plektra/ESP32-PDM-base/3d/ESD_GG0402_KAV.step

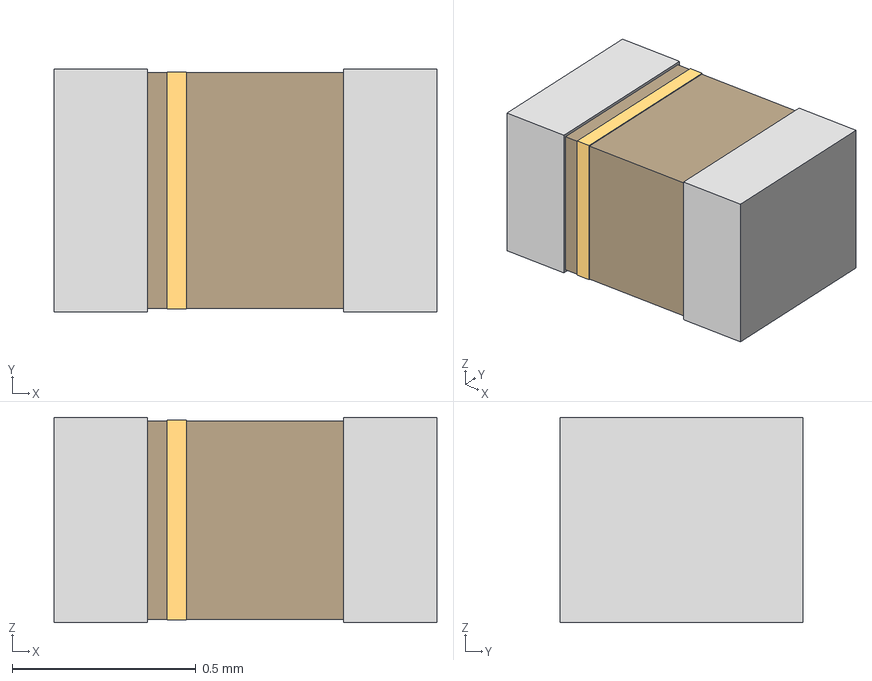
[picture p2: CAD file, 2025-01-17]
3d/ESD_GG0402_KAV.step
1.04 x 0.66 x 0.559 mm
