plektra/ESP32-PDM-base/3d/VLS6045AF-8R2M.STEP

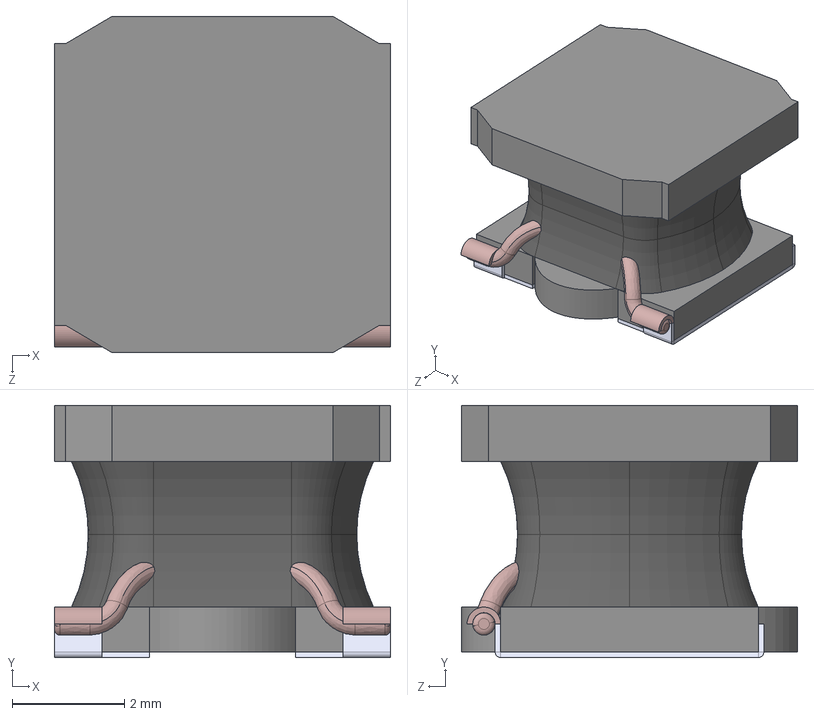
[picture p3: CAD file, 2025-01-17]
3d/VLS6045AF-8R2M.STEP
6.00 x 4.50 x 6.00 mm
