plektra/ESP32-PDM-base/3d/0ZCK0050FF2E.step

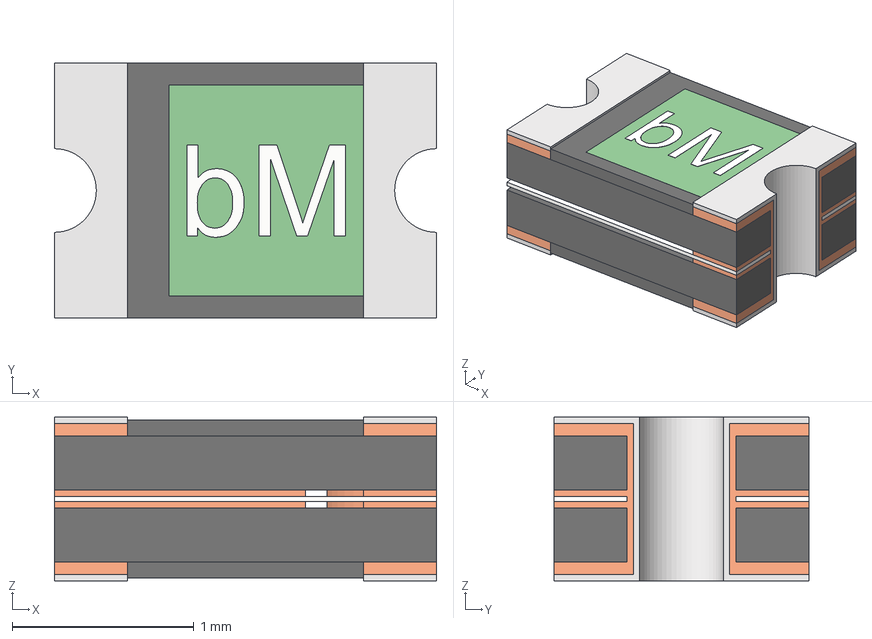
[picture p4: CAD file, 2025-01-17]
3d/0ZCK0050FF2E.step
2.10 x 1.40 x 0.9 mm
0ZCK0050FF2E_PART1
0ZCK0050FF2E_PART2
0ZCK0050FF2E_PART3
0ZCK0050FF2E_PART4
0ZCK0050FF2E_PART5
0ZCK0050FF2E_PART6
0ZCK0050FF2E_PART7
0ZCK0050FF2E_PART8
0ZCK0050FF2E_PART9
0ZCK0050FF2E_PART10
0ZCK0050FF2E_PART11
0ZCK0050FF2E_PART12
0ZCK0050FF2E_PART13
0ZCK0050FF2E_PART14
0ZCK0050FF2E_PART15
