plektra/ESP32-PDM-base/3d/USB4115-03-C_REVB4.step

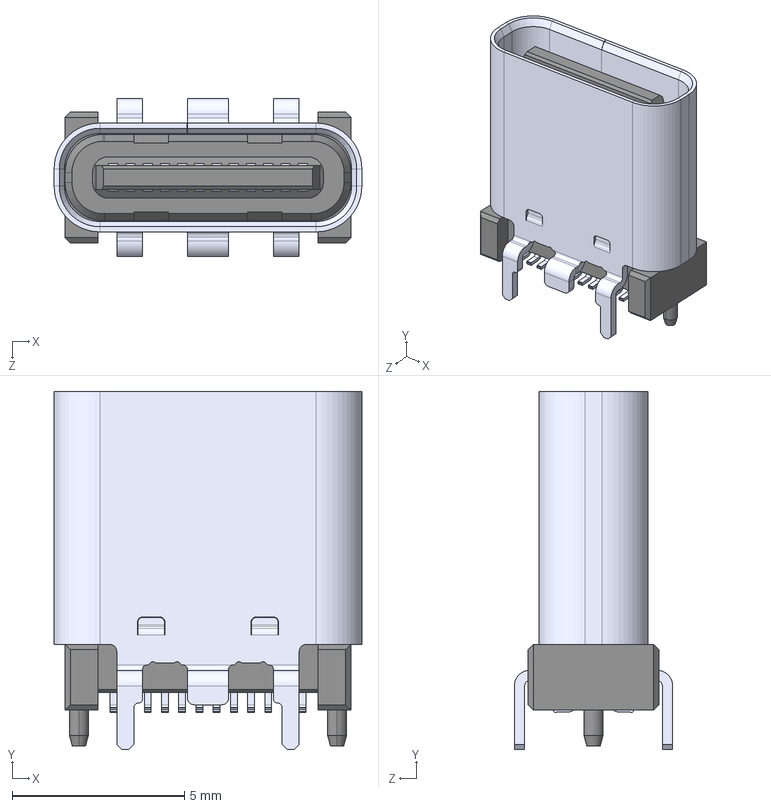
[picture p5: CAD file, 2025-01-17]
3d/USB4115-03-C_REVB4.step
8.94 x 10.4 x 4.60 mm
