plektra/ESP32-PDM-base/3d/USB4145-03-0170-C_REVA2.step

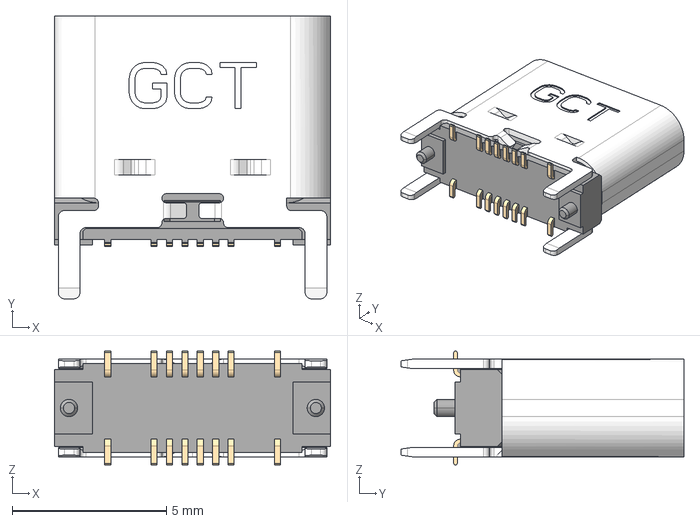
[picture p6: CAD file, 2025-01-17]
3d/USB4145-03-0170-C_REVA2.step
8.95 x 9.16 x 3.69 mm
