plektra/ESP32-PDM-base/3d/0ZCG0050AF2C.step

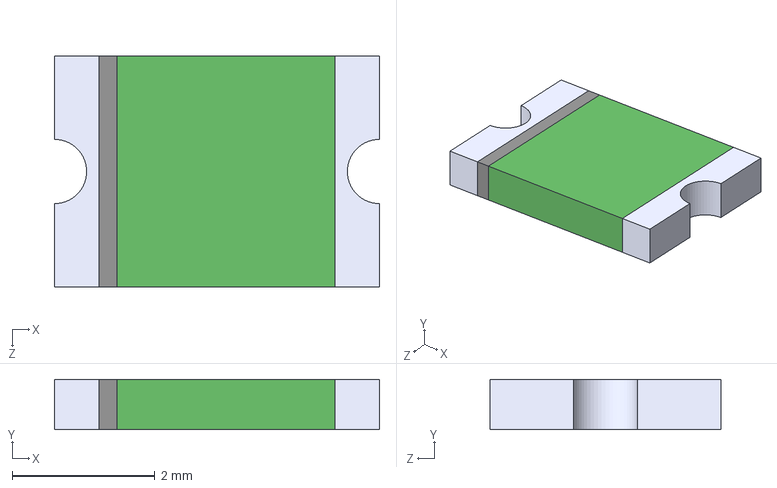
[picture p7: CAD file, 2025-01-17]
3d/0ZCG0050AF2C.step
4.55 x 0.7 x 3.24 mm
