plektra/ESP32-PDM-base/3d/DSS14UTR.step

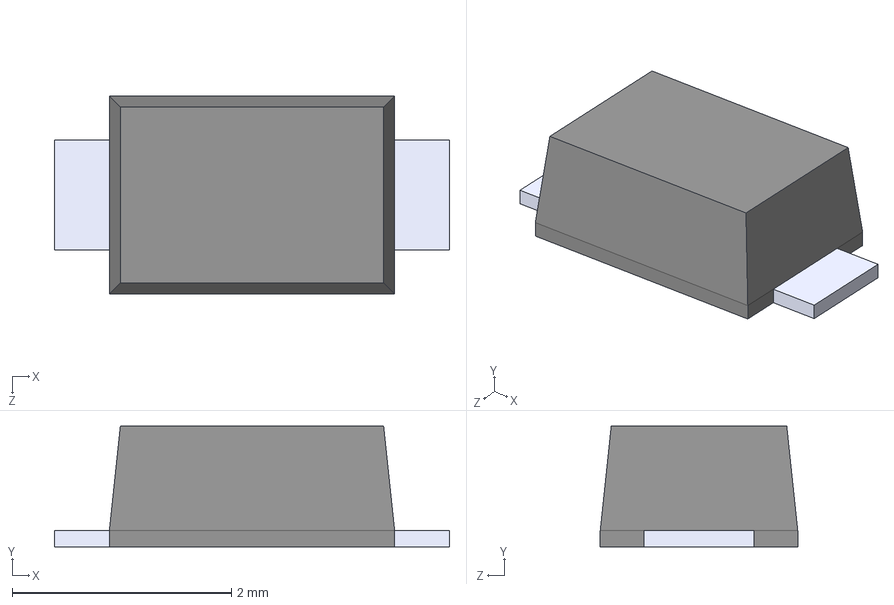
[picture p8: CAD file, 2025-01-17]
3d/DSS14UTR.step
3.60 x 1.10 x 1.80 mm
