plektra/ESP32-PDM-base/ESP32-PDM-BASE.kicad_pcb

## KiCad design ESP32-PDM-BASE.kicad_pcb (2026-10-29)

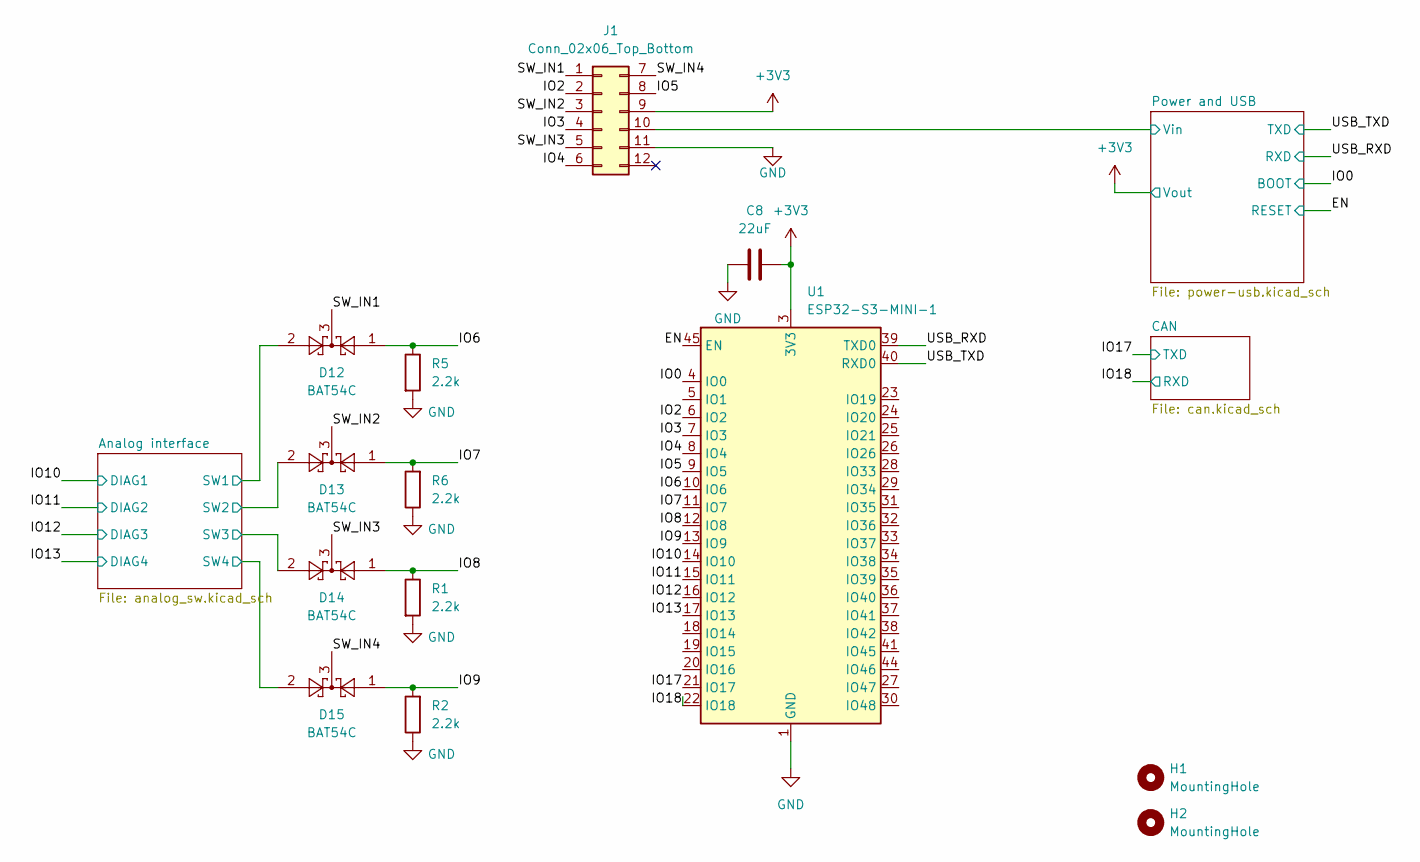
[picture p9: schematic ESP32-PDM-BASE.kicad_sch]

Parts:
C8: 22uF; C_0805_2012Metric
D12, D13, D14, D15: BAT54C; SOT-23
H1, H2: MountingHole
J1: Conn_02x06_Top_Bottom; PinHeader_2x06_P2.54mm_Vertical
R1, R2, R5, R6: 2.2k; R_0402_1005Metric
U1: ESP32-S3-MINI-1; ESP32-S2-MINI-1

Connections:
+3V3: C8.2, J1.9, U1.3 (3V3); also elsewhere on the board
/Analog interface/SW1: D12.2; also elsewhere on the board
/Analog interface/SW2: D13.2; also elsewhere on the board
/Analog interface/SW3: D14.2; also elsewhere on the board
/Analog interface/SW4: D15.2; also elsewhere on the board
/EN: U1.45 (EN); also elsewhere on the board
/IO0: U1.4 (IO0); also elsewhere on the board
/IO2: J1.2, U1.6 (IO2)
/IO3: J1.4, U1.7 (IO3)
/IO4: J1.6, U1.8 (IO4)
/IO5: J1.8, U1.9 (IO5)
/IO6: D12.1, R5.1, U1.10 (IO6)
/IO7: D13.1, R6.2, U1.11 (IO7)
/IO8: D14.1, R1.1, U1.12 (IO8)
/IO9: D15.1, R2.2, U1.13 (IO9)
/IO10: U1.14 (IO10); also elsewhere on the board
/IO11: U1.15 (IO11); also elsewhere on the board
/IO12: U1.16 (IO12); also elsewhere on the board
/IO13: U1.17 (IO13); also elsewhere on the board
/IO17: U1.21 (IO17); also elsewhere on the board
/IO18: U1.22 (IO18); also elsewhere on the board
/Power and USB/Vin: J1.10; also elsewhere on the board
/SW_IN1: D12.3, J1.1
/SW_IN2: D13.3, J1.3
/SW_IN3: D14.3, J1.5
/SW_IN4: D15.3, J1.7
/USB_RXD: U1.39 (TXD0); also elsewhere on the board
/USB_TXD: U1.40 (RXD0); also elsewhere on the board
GND: C8.1, J1.11, R1.2, R2.1, R5.2, R6.1, U1.1 (GND), U1.2 (GND), U1.42 (GND), U1.43 (GND), U1.46 (GND), U1.47 (GND), U1.48 (GND), U1.49 (GND), U1.50 (GND), U1.51 (GND), U1.52 (GND), U1.53 (GND), U1.54 (GND), U1.55 (GND), U1.56 (GND), U1.57 (GND), U1.58 (GND), U1.59 (GND), U1.60 (GND), U1.61 (GND), U1.62 (GND), U1.63 (GND), U1.64 (GND), U1.65 (GND); also elsewhere on the board

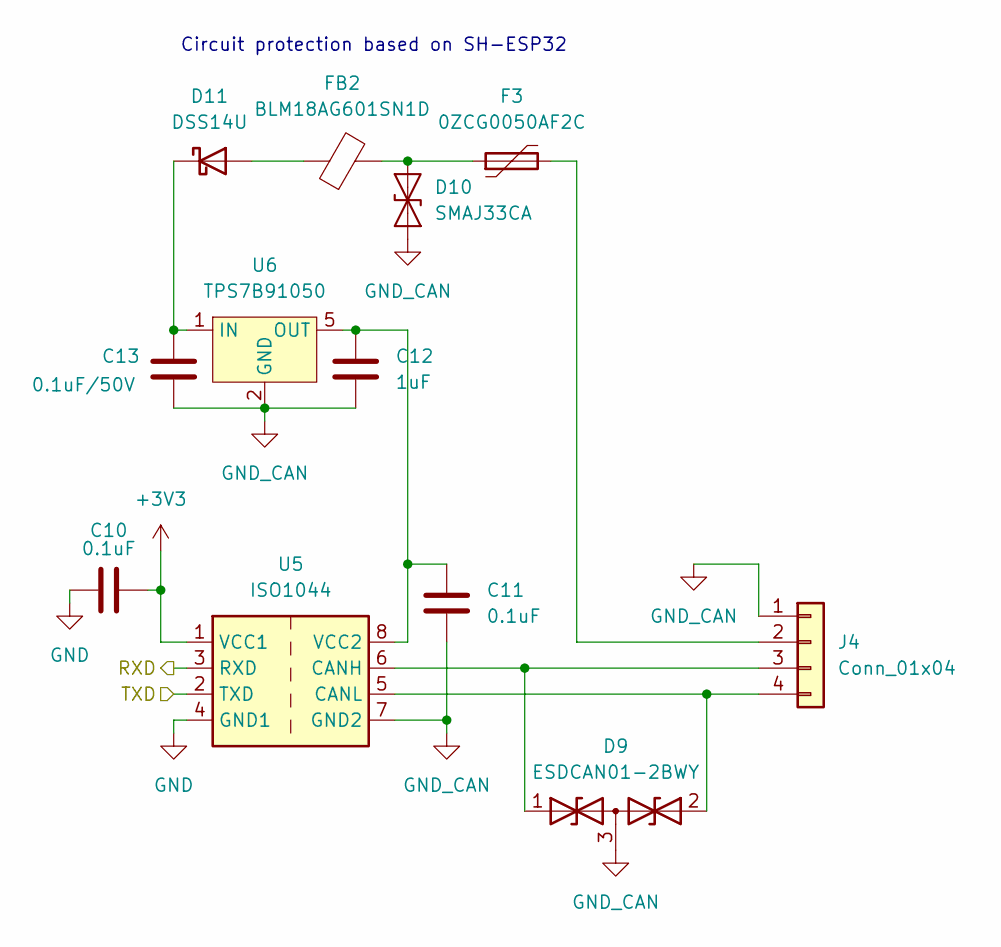
[picture p10: schematic can.kicad_sch]

Parts:
C10, C11: 0.1uF; C_0402_1005Metric
C12: 1uF; C_0402_1005Metric
C13: 0.1uF/50V; C_0603_1608Metric
D9: ESDCAN01-2BWY; SOT-323_SC-70
D10: SMAJ33CA; D_SMA
D11: DSS14U; D_SOD-123F
F3: 0ZCG0050AF2C
FB2: BLM18AG601SN1D; L_0603_1608Metric
J4: Conn_01x04; PhoenixContact_MCV_1,5_4-G-3.81_1x04_P3.81mm_Vertical
U5: ISO1044; SOIC-8_3.9x4.9mm_P1.27mm
U6: TPS7B91050; SOT-23-5

Connections:
+3V3: C10.2, U5.1 (VCC1); also elsewhere on the board
/IO17: U5.2 (TXD); also elsewhere on the board
/IO18: U5.3 (RXD); also elsewhere on the board
GND: C10.1, U5.4 (GND1); also elsewhere on the board
GND_CAN: C11.2, C12.2, C13.2, D9.3 (common), D10.1 (A1), J4.1, U5.7 (GND2), U6.2 (GND)
unnamed: D9.1 (A1), J4.3, U5.6 (CANH)
unnamed: D9.2 (A2), J4.4, U5.5 (CANL)
unnamed: D10.2 (A2), F3.1, FB2.2
unnamed: D11.2 (A), FB2.1
unnamed: C13.1, D11.1 (K), U6.1 (IN)
unnamed: F3.2, J4.2
unnamed: C11.1, C12.1, U5.8 (VCC2), U6.5 (OUT)

Notes on the sheet:
Circuit protection based on SH-ESP32

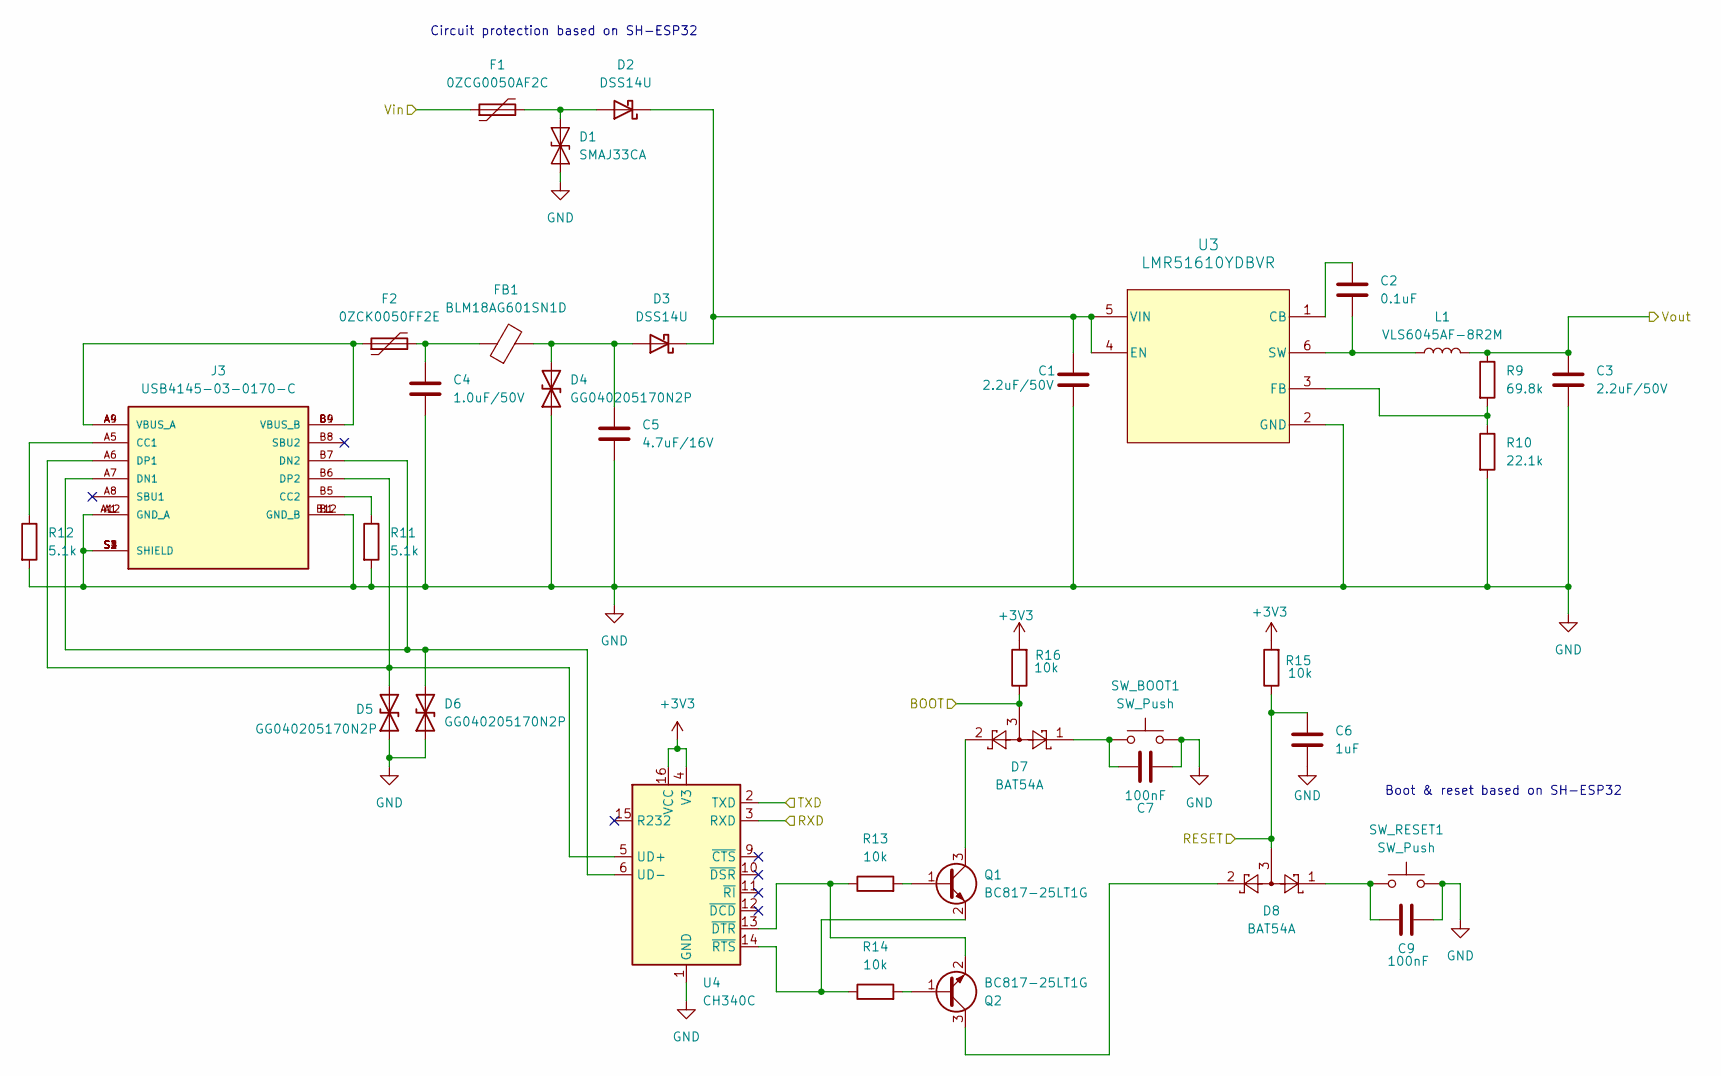
[picture p11: schematic power-usb.kicad_sch]

Parts:
C1, C3: 2.2uF/50V; C_0603_1608Metric
C2: 0.1uF; C_0603_1608Metric
C4: 1.0uF/50V; C_0603_1608Metric
C5: 4.7uF/16V; C_0603_1608Metric
C6: 1uF; C_0603_1608Metric
C7, C9: 100nF; C_0805_2012Metric
D1: SMAJ33CA; D_SMA
D2, D3: DSS14U; D_SOD-123F
D4, D5, D6: GG040205170N2P; D_0402_1005Metric
D7, D8: BAT54A; SOT-23
F1: 0ZCG0050AF2C
F2: 0ZCK0050FF2E; 0ZCK_BEL
FB1: BLM18AG601SN1D; L_0603_1608Metric
J3: USB4145-03-0170-C; GCT_USB4145-03-0170-C; PARTREV A2
L1: VLS6045AF-8R2M; IND_VLS6045AF-8R2M
Q1, Q2: BC817-25LT1G; SOT-23-3
R9: 69.8k; R_0603_1608Metric
R10: 22.1k; R_0603_1608Metric
R11, R12: 5.1k; R_0402_1005Metric
R13, R14, R15, R16: 10k; R_0402_1005Metric
SW_BOOT1: SW_Push; SW_SPST_PTS647_Sx38
SW_RESET1: SW_Push; SW_SPST_PTS647_Sx38
U3: LMR51610YDBVR; LMR51610
U4: CH340C; SOIC-16_3.9x9.9mm_P1.27mm

Connections:
+3V3: C3.1, L1.2, R9.1, R15.2, R16.2, U4.4 (V3), U4.16 (VCC); also elsewhere on the board
/EN: C6.1, D8.3, R15.1; also elsewhere on the board
/IO0: D7.3, R16.1; also elsewhere on the board
/Power and USB/Vin: F1.1; also elsewhere on the board
/USB_RXD: U4.3 (RXD); also elsewhere on the board
/USB_TXD: U4.2 (TXD); also elsewhere on the board
GND: C1.1, C3.2, C4.2, C5.2, C6.2, C7.1, C9.2, D1.1 (A1), D4.1 (A1), D5.1 (A1), D6.1 (A1), J3.A1 (GND_A), J3.A12 (GND_A), J3.B1 (GND_B), J3.B12 (GND_B), J3.S1 (SHIELD), J3.S2 (SHIELD), J3.S3 (SHIELD), J3.S4 (SHIELD), R10.2, R11.2, R12.2, SW_BOOT1.2, SW_RESET1.2, U3.2 (GND), U4.1 (GND); also elsewhere on the board
unnamed: C4.1, F2.2, FB1.1
unnamed: C7.2, D7.1, SW_BOOT1.1
unnamed: C9.1, D8.1, SW_RESET1.1
unnamed: D1.2 (A2), D2.2 (A), F1.2
unnamed: C1.2, D2.1 (K), D3.1 (K), U3.4 (EN), U3.5 (VIN)
unnamed: C5.1, D3.2 (A), D4.2 (A2), FB1.2
unnamed: D5.2 (A2), J3.A6 (DP1), J3.B6 (DP2), U4.5 (UD+)
unnamed: D6.2 (A2), J3.A7 (DN1), J3.B7 (DN2), U4.6 (UD-)
unnamed: F2.1, J3.A4 (VBUS_A), J3.A9 (VBUS_A), J3.B4 (VBUS_B), J3.B9 (VBUS_B)
unnamed: J3.A5 (CC1), R12.1
unnamed: J3.B5 (CC2), R11.1
unnamed: Q1.1 (B), R13.2
unnamed: D7.2, Q1.3 (C)
unnamed: Q1.2 (E), R14.1, U4.14 (~RTS)
unnamed: Q2.1 (B), R14.2
unnamed: D8.2, Q2.3 (C)
unnamed: Q2.2 (E), R13.1, U4.13 (~DTR)
unnamed: C2.1, U3.1 (CB)
unnamed: R9.2, R10.1, U3.3 (FB)
unnamed: C2.2, L1.1, U3.6 (SW)

Notes on the sheet:
Circuit protection based on SH-ESP32
Boot & reset based on SH-ESP32

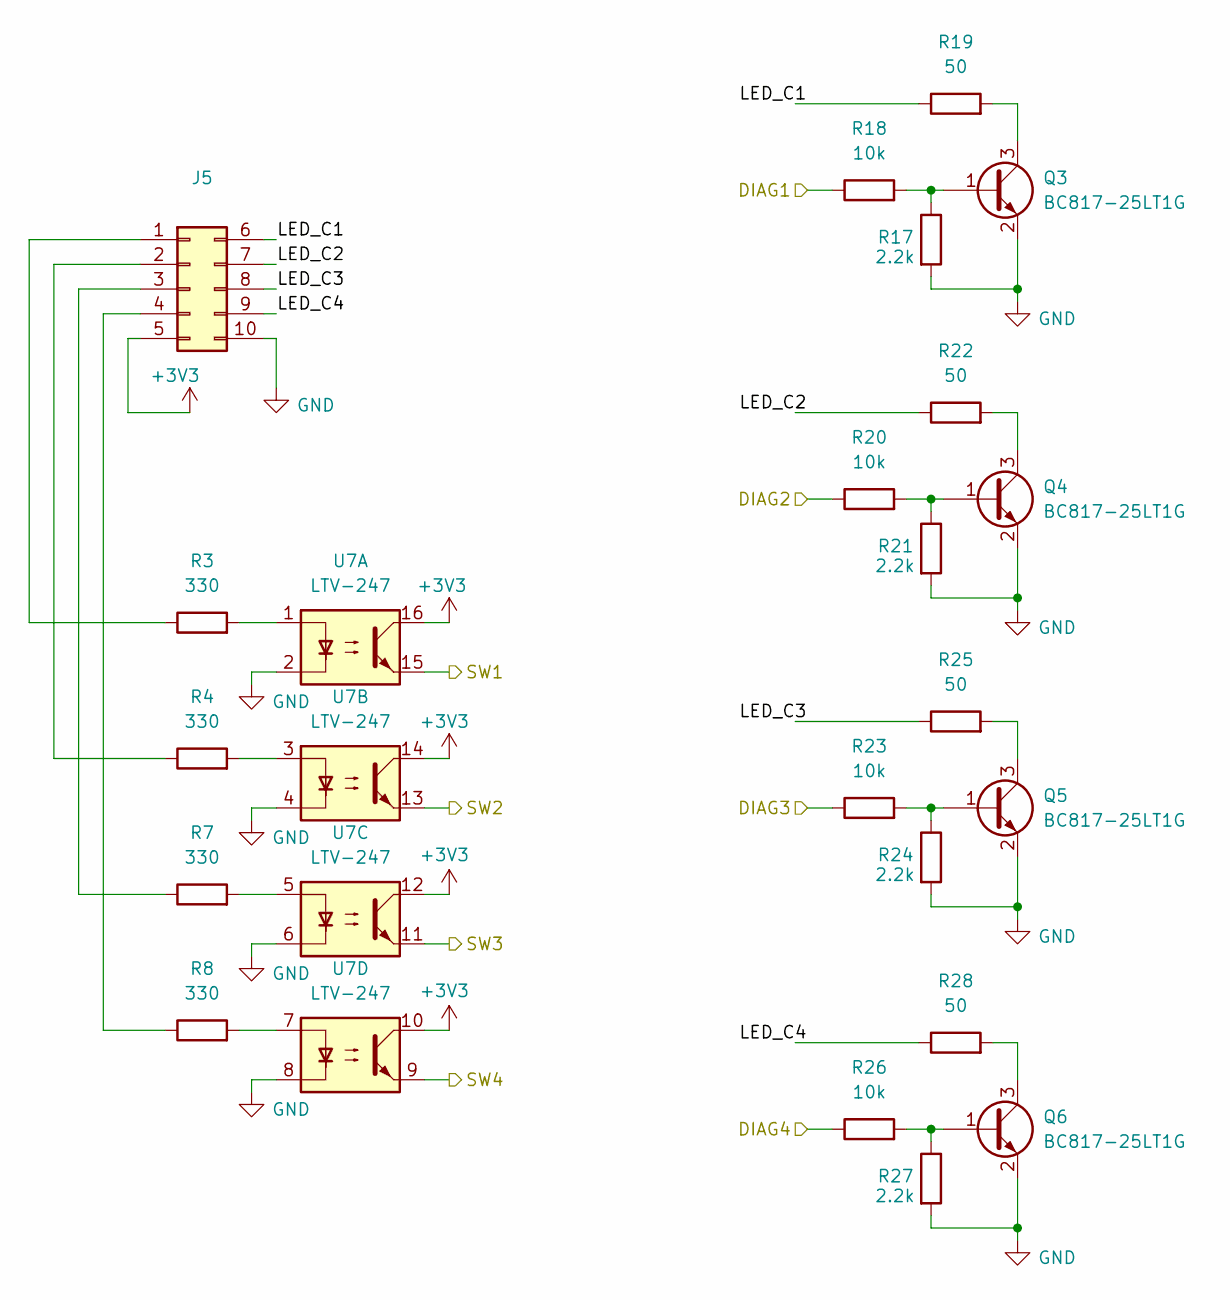
[picture p12: schematic analog_sw.kicad_sch]

Parts:
J5: Conn_02x05_Top_Bottom; PinHeader_2x05_P2.54mm_Vertical
Q3, Q4, Q5, Q6: BC817-25LT1G; SOT-23-3
R3, R4, R7, R8: 330; R_0603_1608Metric
R17, R21, R24, R27: 2.2k; R_0402_1005Metric
R18, R20, R23, R26: 10k; R_0402_1005Metric
R19, R22, R25, R28: 50; R_0402_1005Metric
U7: LTV-247; SOP-16_4.4x10.4mm_P1.27mm

Connections:
+3V3: J5.5, U7.10, U7.12, U7.14, U7.16; also elsewhere on the board
/Analog interface/LED_C1: J5.6, R19.1
/Analog interface/LED_C2: J5.7, R22.1
/Analog interface/LED_C3: J5.8, R25.1
/Analog interface/LED_C4: J5.9, R28.1
/Analog interface/SW1: U7.15; also elsewhere on the board
/Analog interface/SW2: U7.13; also elsewhere on the board
/Analog interface/SW3: U7.11; also elsewhere on the board
/Analog interface/SW4: U7.9; also elsewhere on the board
/IO10: R18.1; also elsewhere on the board
/IO11: R20.1; also elsewhere on the board
/IO12: R23.1; also elsewhere on the board
/IO13: R26.1; also elsewhere on the board
GND: J5.10, Q3.2 (E), Q4.2 (E), Q5.2 (E), Q6.2 (E), R17.2, R21.2, R24.2, R27.2, U7.2, U7.4, U7.6, U7.8; also elsewhere on the board
unnamed: J5.1, R3.1
unnamed: J5.2, R4.1
unnamed: J5.3, R7.1
unnamed: J5.4, R8.1
unnamed: Q3.1 (B), R17.1, R18.2
unnamed: Q3.3 (C), R19.2
unnamed: Q4.1 (B), R20.2, R21.1
unnamed: Q4.3 (C), R22.2
unnamed: Q5.1 (B), R23.2, R24.1
unnamed: Q5.3 (C), R25.2
unnamed: Q6.1 (B), R26.2, R27.1
unnamed: Q6.3 (C), R28.2
unnamed: R3.2, U7.1
unnamed: R4.2, U7.3
unnamed: R7.2, U7.5
unnamed: R8.2, U7.7

Board: 2 copper layers, 82 parts (0 on the bottom side), 77 nets, no tracks yet.
