plektra/ESP32-PDM-base/(commit log)

2025-01-17 initial schematic draft
    [0ZCG0050AF2C.step, 0ZCK0050FF2E.step, DSS14UTR.step, ESD_GG0402_KAV.step, ESP32-PDM-BASE.kicad_pcb, ESP32-PDM-BASE.kicad_sch, ESP32-S3-MINI-1-new.STEP, USB4115-03-C_REVB4.step]
2026-10-29 Add standalone schematic netlist/connectivity checker script
    Parses KiCad 8 .kicad_sch files directly (no KiCad install needed),
    resolves the sheet hierarchy and prints nets plus connectivity warnings.
    Claude-Session: https://claude.ai/code/session_013YUXWHqfq6VEyfY5gyHT7F
2026-10-29 unfinished work
    [ESP32-PDM-BASE.kicad_pcb, ESP32-PDM-BASE.kicad_sch, analog_sw.kicad_sch, can.kicad_sch, power-usb.kicad_sch]
2026-10-29 Fix LED driver bias, add ST pull-ups, name TPS7B91 NC pins
    - Swap LED driver base resistors: 2.2k series (R18/R20/R23/R26) and
    10k pull-down (R17/R21/R24/R27). The old 10k/2.2k divider only gave
    ~0.6 V at the base, so the NPNs never turned on.
    - Add 10k pull-ups R29-R32 from IO2-IO5 to +3V3 for the open-drain ST
    outputs of the TPS1H100-Q1 switches on the output module.
    - Name TPS7B91 pins 3 and 4 "NC" (datasheet: not internally connected).
    ERC violation count unchanged (45, all pre-existing).
    [ESP32-PDM-BASE.kicad_sch, analog_sw.kicad_sch, can.kicad_sch]
2026-10-29 Apply JLCPCB BOM audit fixes and add module ID / switch sense
    - Remove CH340C and auto-reset circuit; USB-C goes to native USB
    (IO19 = D-, IO20 = D+). UART0 left unconnected.
    - USB-C: HRO TYPE-C-31-M-12 (shell pins renumbered SH to match footprint).
    - F1/F3: 1812L050/60GR (60 V, 500 mA hold); old part was rated 30 V max.
    - D2/D3/D11: DSK16 (60 V) replacing out-of-stock DSS14U.
    - D9: PESD2CAN replacing unavailable ESDCAN01-2BWY (SOT-23).
    - L1: SWPA6045S8R2MT (Isat 3.9 A > LMR51610 peak limit 1.95 A).
    - Feedback divider 68k/22k (basic parts): Vout 3.27 V with Vref 0.8 V.
    - Basic-library swaps: TS-1187A buttons, 0805 2.2uF/50V, 49.9 R,
    BC817-40.
    - Move the ST pull-ups to the output module.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
    [ESP32-PDM-BASE.kicad_sch, analog_sw.kicad_sch, can.kicad_sch, power-usb.kicad_sch]
2026-10-29 Harden inputs for 30 V, finish BOM swaps, clean up ERC
    - Switch inputs R3/R4/R7/R8: 330 R -> 4.7k 1206. 2 mA at 10.5 V,
    6.1 mA / 0.18 W at 30 V. LTV-247 CTR >= 50 % at 5 mA, ~0.7x at 2 mA
    (datasheet fig. 10) -> >= 0.7 mA out vs 0.33 mA needed.
    - D1: SMAJ30CA (clamp 48.4 V, below the 50 V input caps).
    - D10: SMAJ18CA on NMEA 2000 NET-S (9-16 V); clamp 29.2 V protects the
    TPS7B91 (42 V abs max). SMAJ33CA clamped at 53 V.
    - F2: SMD0805B050TF; D4-D6: PESD0402V05; J4: WJ15EDGVC-3.81-04P
    (MCV 1.5 clone, footprint kept - verify against datasheet).
    - ERC: PWR_FLAGs on +3V3, GND, VBUS, buck VIN, CAN LDO input, GND_CAN;
    LMR51610 symbol CB/FB/SW pins passive; spare GPIOs no-connect;
    orphane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
    [ESP32-PDM-BASE.kicad_sch, analog_sw.kicad_sch, can.kicad_sch, power-usb.kicad_sch]
2026-10-30 Replace opto switch inputs with protected direct inputs
    The physical switch now drives the output EN without the LTV-247 and
    without depending on the 3.3 V rail. Per input:
    - SMAJ30CA TVS at J5 (surge/ESD on long switch cables)
    - 4.7k 1206 load to GND (contact wetting 2.5 mA @ 12 V, 6.4 mA @ 30 V)
    - 10k 1206 series + 4.7k/BZT52C3V3 divider-clamp + 100 nF:
    node ~3.2 V for 10.5-30 V in, EN threshold ~7.5 V, tau ~0.3 ms,
    negative spikes clamped by the Zener/TVS
    - node -> existing BAT54C diode-OR -> SW_IN (module EN)
    - R30-R33 now 10k series from the node to IO14/IO15/IO16/IO21,
    limiting back-feed into an unpowered ESP32 to ~0.3 mA
    ERC: 4 left (BC817 lib_symbol_mismatch).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
    [ESP32-PDM-BASE.kicad_sch, analog_sw.kicad_sch]
