plektra/ESP32-PDM-base/(notices)

Notices in the files:
3d/0ZCK0050FF2E.step:
author */ ('License CC BY-ND 4.0'),
